softcomplex/Digirig-Lite/docs/digirig-lite-kit.png

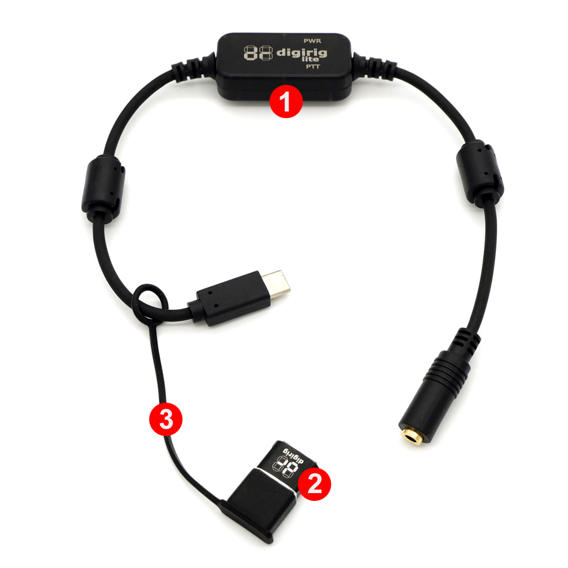
docs/digirig-lite-kit.png
