softcomplex/Digirig-Lite/mechanical/back-sticker.pdf

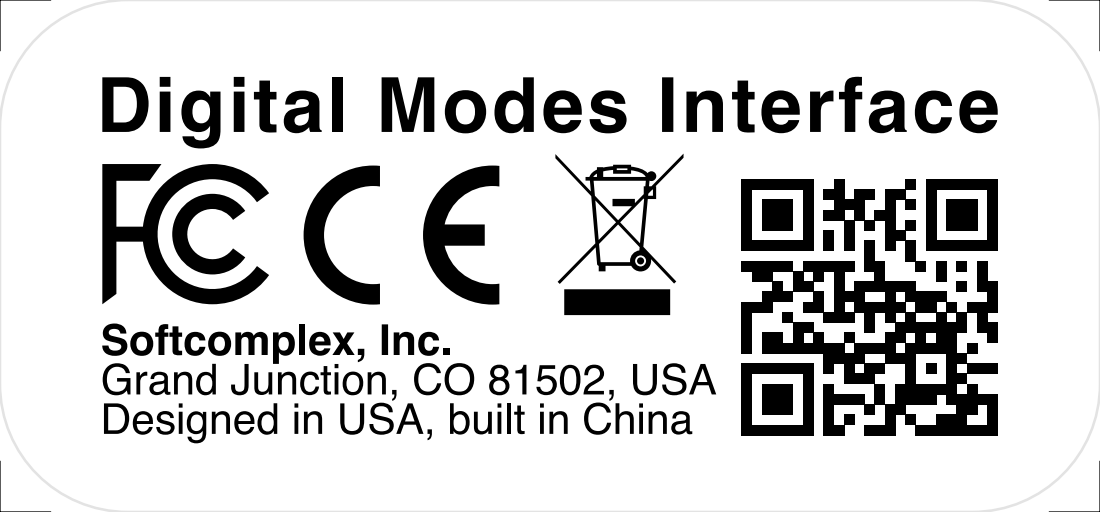
[picture p2: page 1]
