softcomplex/Digirig-Lite/mechanical/front-sticker.pdf

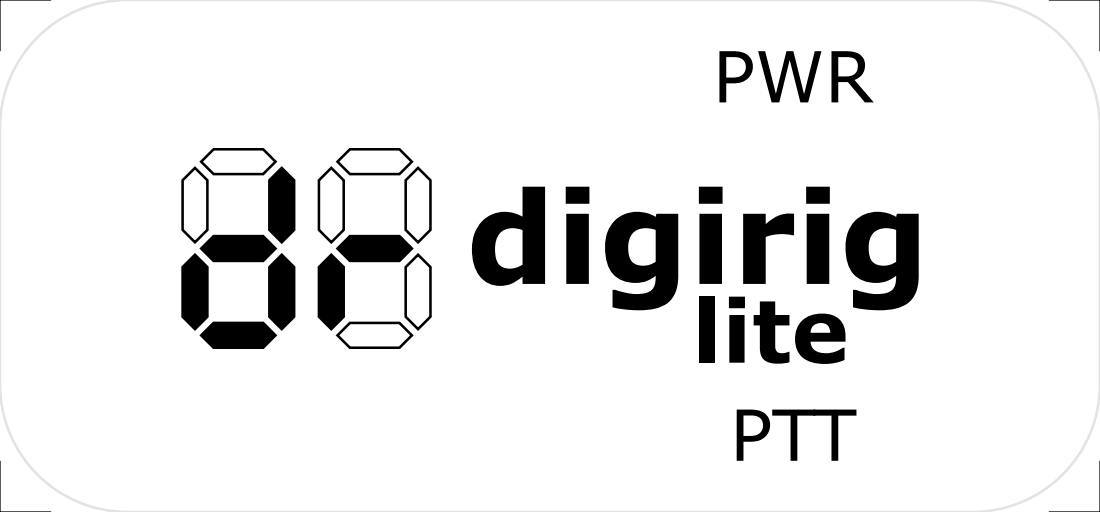
[picture p3: page 1]
