softcomplex/Digirig-Lite/electric/digirig-lite.kicad_pcb

## KiCad design electric/digirig-lite.kicad_pcb (2025-08-05)

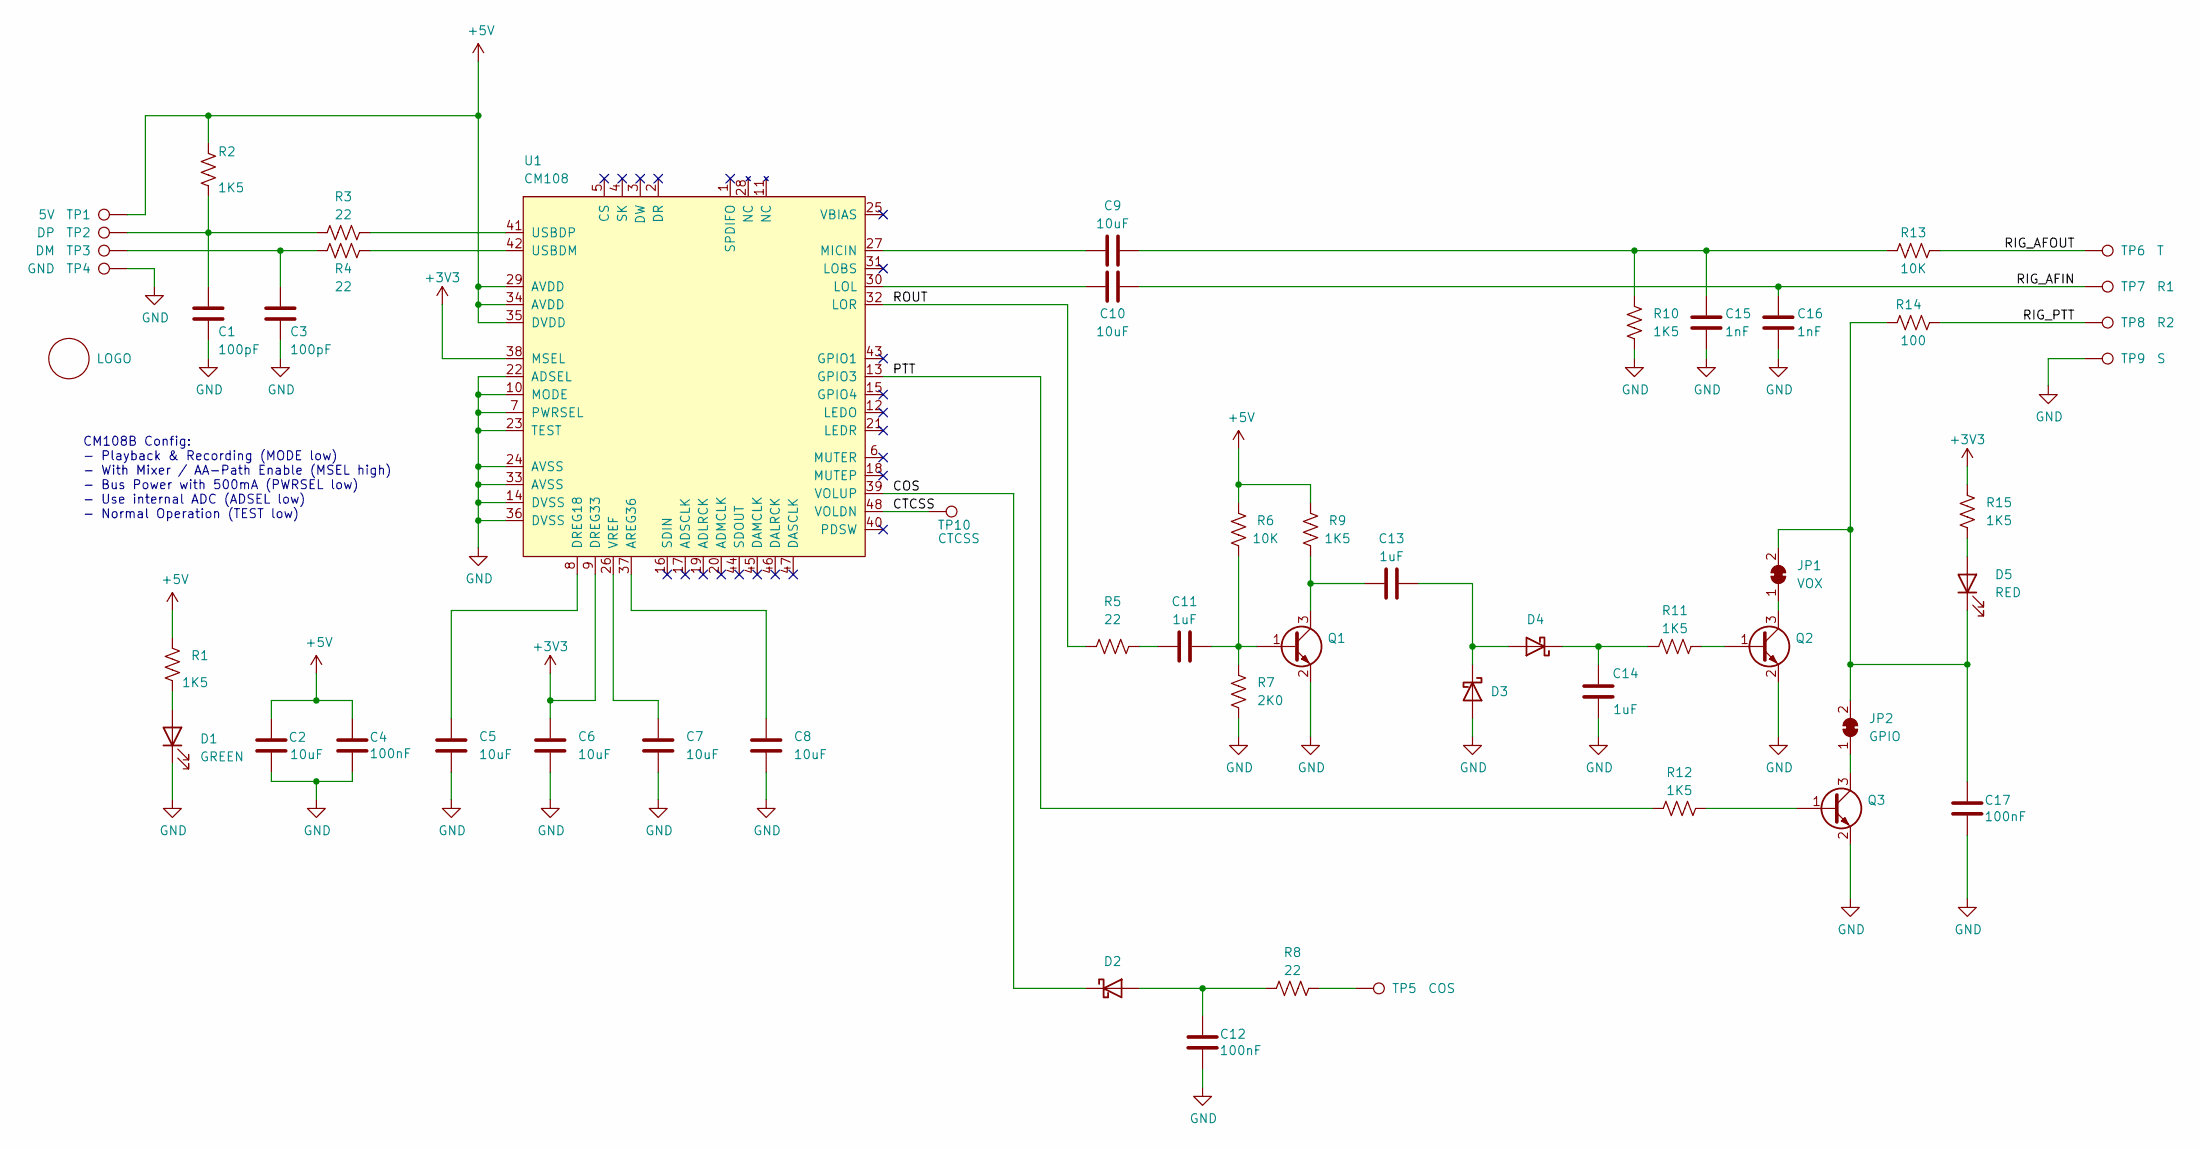
[picture p4: schematic digirig-lite.kicad_sch, Digirig Lite]

Parts:
C1, C3: 100pF; C_0402_1005Metric; LCSC C1546
C2, C5, C6, C7, C8, C9, C10: 10uF; C_0402_1005Metric; LCSC C15525
C4, C12, C17: 100nF; C_0402_1005Metric; LCSC C1525
C11, C13, C14: 1uF; C_0402_1005Metric; LCSC C52923
C15, C16: 1nF; C_0402_1005Metric; LCSC C1523
D1: GREEN; LED_0603_1608Metric; LCSC C3028829
D2, D3, D4: GS2005ELD; D_SOD-923; LCSC C18716421
D5: RED; LED_0603_1608Metric; LCSC C2286
JP1: VOX; SolderJumper-2_P1.3mm_Bridged_RoundedPad1.0x1.5mm
JP2: GPIO; SolderJumper-2_P1.3mm_Bridged_RoundedPad1.0x1.5mm
L1: LOGO; digirig-logo-6mm
Q1, Q2, Q3: MMBT5551L; SOT-23; LCSC C2145
R1, R2, R9, R10, R11, R12, R15: 1K5; R_0402_1005Metric; LCSC C25867
R3, R4, R5, R8: 22; R_0402_1005Metric; LCSC C25092
R6, R13: 10K; R_0402_1005Metric; LCSC C25744
R7: 2K0; R_0402_1005Metric; LCSC C4109
R14: 100; R_0402_1005Metric; LCSC C25076
TP1: 5V; TestPoint_Pad_D1.5mm
TP2: DP; TestPoint_Pad_D1.5mm
TP3: DM; TestPoint_Pad_D1.5mm
TP4: GND; TestPoint_Pad_D1.5mm
TP5: COS; TestPoint_Pad_D1.5mm
TP6: T; TestPoint_Pad_D1.5mm
TP7: R1; TestPoint_Pad_D1.5mm
TP8: R2; TestPoint_Pad_D1.5mm
TP9: S; TestPoint_Pad_D1.5mm
TP10: CTCSS; TestPoint_Pad_D1.5mm
U1: CM108; LQFP-48_7x7mm_P0.5mm; LCSC C371347

Connections:
+3V3: C6.1, R15.1, U1.9 (DREG33), U1.38 (MSEL)
+5V: C2.1, C4.1, R1.1, R2.2, R6.1, R9.1, TP1.1, U1.29 (AVDD), U1.34 (AVDD), U1.35 (DVDD)
/COS: D2.1 (K), U1.39 (VOLUP)
/CTCSS: TP10.1, U1.48 (VOLDN)
/PTT: R12.2, U1.13 (GPIO3)
/RIG_AFIN: C10.1, C16.1, TP7.1
/RIG_AFOUT: R13.1, TP6.1
/RIG_PTT: R14.1, TP8.1
/ROUT: R5.1, U1.32 (LOR)
GND: C1.2, C2.2, C3.2, C4.2, C5.2, C6.2, C7.2, C8.2, C12.2, C14.1, C15.2, C16.2, C17.2, D1.1 (K), D3.2 (A), Q1.2 (E), Q2.2 (E), Q3.2 (E), R7.2, R10.2, TP4.1, TP9.1, U1.7 (PWRSEL), U1.10 (MODE), U1.14 (DVSS), U1.22 (ADSEL), U1.23 (TEST), U1.24 (AVSS), U1.33 (AVSS), U1.36 (DVSS)
unnamed: C1.1, R2.1, R3.2, TP2.1
unnamed: C3.1, R4.2, TP3.1
unnamed: C11.2, R5.2
unnamed: C9.1, C15.1, R10.1, R13.2
unnamed: D1.2 (A), R1.2
unnamed: C12.1, D2.2 (A), R8.2
unnamed: C13.1, D3.1 (K), D4.2 (A)
unnamed: C14.2, D4.1 (K), R11.2
unnamed: D5.2 (A), R15.2
unnamed: C17.1, D5.1 (K), JP1.2 (B), JP2.2 (B), R14.2
unnamed: JP1.1 (A), Q2.3 (C)
unnamed: JP2.1 (A), Q3.3 (C)
unnamed: C11.1, Q1.1 (B), R6.2, R7.1
unnamed: C13.2, Q1.3 (C), R9.2
unnamed: Q2.1 (B), R11.1
unnamed: Q3.1 (B), R12.1
unnamed: R8.1, TP5.1
unnamed: C8.1, U1.37 (AREG36)
unnamed: C5.1, U1.8 (DREG18)
unnamed: C10.2, U1.30 (LOL)
unnamed: C9.2, U1.27 (MICIN)
unnamed: R4.1, U1.42 (USBDM)
unnamed: R3.1, U1.41 (USBDP)
unnamed: C7.1, U1.26 (VREF)

Notes on the sheet:
CM108B Config: - Playback & Recording (MODE low) - With Mixer / AA-Path Enable (MSEL high) - Bus Power with 500mA (PWRSEL low) - Use internal ADC (ADSEL low) - Normal Operation (TEST low)

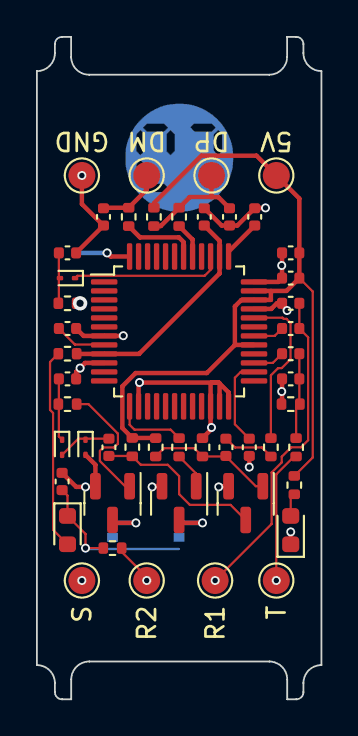
[picture p5: board digirig-lite.kicad_pcb from above]

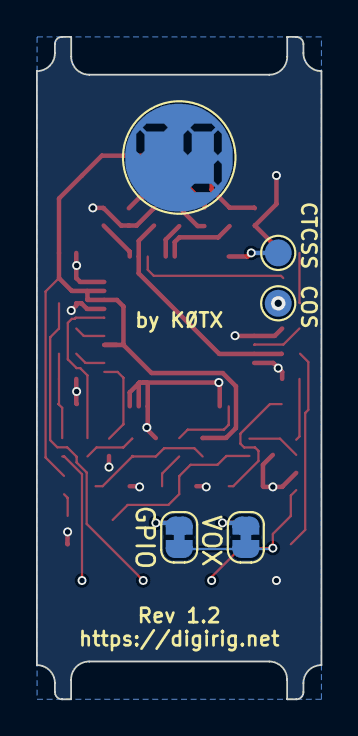
[picture p6: board digirig-lite.kicad_pcb from below]

Board: 2 copper layers, 15.8 x 36.8 mm, 54 parts (4 on the bottom side), 34 nets.
