softcomplex/Digirig-Lite/electric/digirig-light.kicad_pcb

## KiCad design electric/digirig-light.kicad_pcb (2024-03-08)

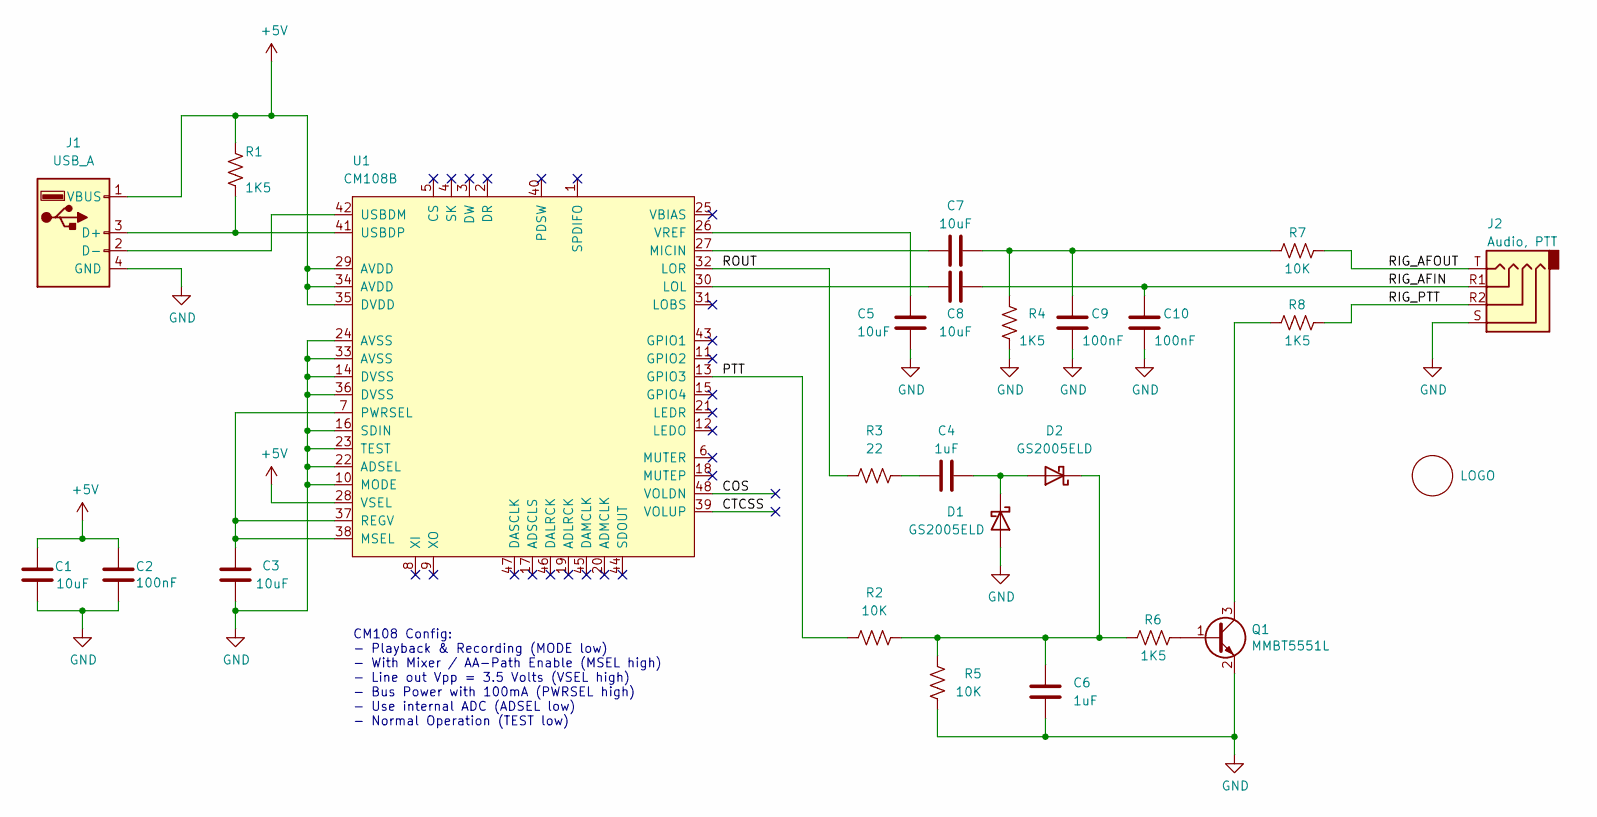
[picture p7: schematic digirig-light.kicad_sch, Digirig Light]

Parts:
C1, C3, C5, C7, C8: 10uF; C_0402_1005Metric; LCSC C15525
C2, C9, C10: 100nF; C_0402_1005Metric; LCSC C1525
C4, C6: 1uF; C_0402_1005Metric; LCSC C52923
D1, D2: GS2005ELD; D_SOD-923; LCSC C18716421
J1: USB_A; USB_A_PCB_traces_small
J2: PJ-320A; Jack_3.5mm_PJ320D_Horizontal; LCSC C431535
L1: LOGO; digirig-logo-6mm
Q1: MMBT5551L; SOT-23; LCSC C152516
R1, R4, R6, R8: 1K5; R_0402_1005Metric; LCSC C25867
R2, R5, R7: 10K; R_0402_1005Metric; LCSC C25744
R3: 22; R_0402_1005Metric; MPN C25092
U1: CM108B; LQFP-48_7x7mm_P0.5mm; LCSC C371347

Connections:
+5V: C1.1, C2.1, J1.1 (VBUS), R1.2, U1.28 (VSEL), U1.29 (AVDD), U1.34 (AVDD), U1.35 (DVDD)
/COS: U1.48 (VOLDN)
/CTCSS: U1.39 (VOLUP)
/PTT: R2.2, U1.13 (GPIO3)
/RIG_AFIN: C8.1, C10.1, J2.R1
/RIG_AFOUT: J2.T, R7.1
/RIG_PTT: J2.R2, R8.1
/ROUT: R3.1, U1.32 (LOR)
GND: C1.2, C2.2, C3.1, C5.2, C6.2, C9.2, C10.2, D1.2 (A), J1.4 (GND), J2.S, Q1.2 (E), R4.2, R5.1, U1.10 (MODE), U1.14 (DVSS), U1.16 (SDIN), U1.22 (ADSEL), U1.23 (TEST), U1.24 (AVSS), U1.33 (AVSS), U1.36 (DVSS)
unnamed: C4.2, R3.2
unnamed: C7.1, C9.1, R4.1, R7.2
unnamed: C4.1, D1.1 (K), D2.2 (A)
unnamed: C6.1, D2.1 (K), R2.1, R5.2, R6.2
unnamed: J1.3 (D+), R1.1, U1.41 (USBDP)
unnamed: J1.2 (D-), U1.42 (USBDM)
unnamed: Q1.1 (B), R6.1
unnamed: Q1.3 (C), R8.2
unnamed: C8.2, U1.30 (LOL)
unnamed: C7.2, U1.27 (MICIN)
unnamed: C3.2, U1.7 (PWRSEL), U1.37 (REGV), U1.38 (MSEL)
unnamed: C5.1, U1.26 (VREF)

Notes on the sheet:
CM108 Config: - Playback & Recording (MODE low) - With Mixer / AA-Path Enable (MSEL high) - Line out Vpp = 3.5 Volts (VSEL high) - Bus Power with 100mA (PWRSEL high) - Use internal ADC (ADSEL low) - Normal Operation (TEST low)

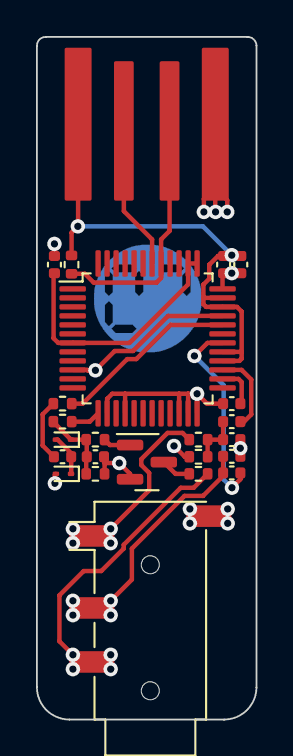
[picture p8: board digirig-light.kicad_pcb from above]

Board: 2 copper layers, 12.2 x 37.9 mm, 25 parts (0 on the bottom side), 19 nets.
