softcomplex/Digirig-Lite/(commit log)

2024-03-08 Revision 1.1
    - PTT by tone circuit modification
    - CM108B output voltage config change from 2.5V to 3.5V
    [digirig-light-1_0.kicad_sch, digirig-light.kicad_pcb, digirig-light.kicad_sch]
2024-04-04 Revision 1.2
    - added amplification for VOX PTT on right audio channel
    - added LED indication for power and PTT
    - PCB redone for cable form factor
    - project renamed from Digirig Light to Digirig Lite
