softcomplex/Digirig-Lite/(notices)

Notices in the files:
electric/digirig-light.kicad_sch:
GNU General Public License v3.0
